suneids/Glove/electronics/Glove_Alrium/Glove_Altium.pdf

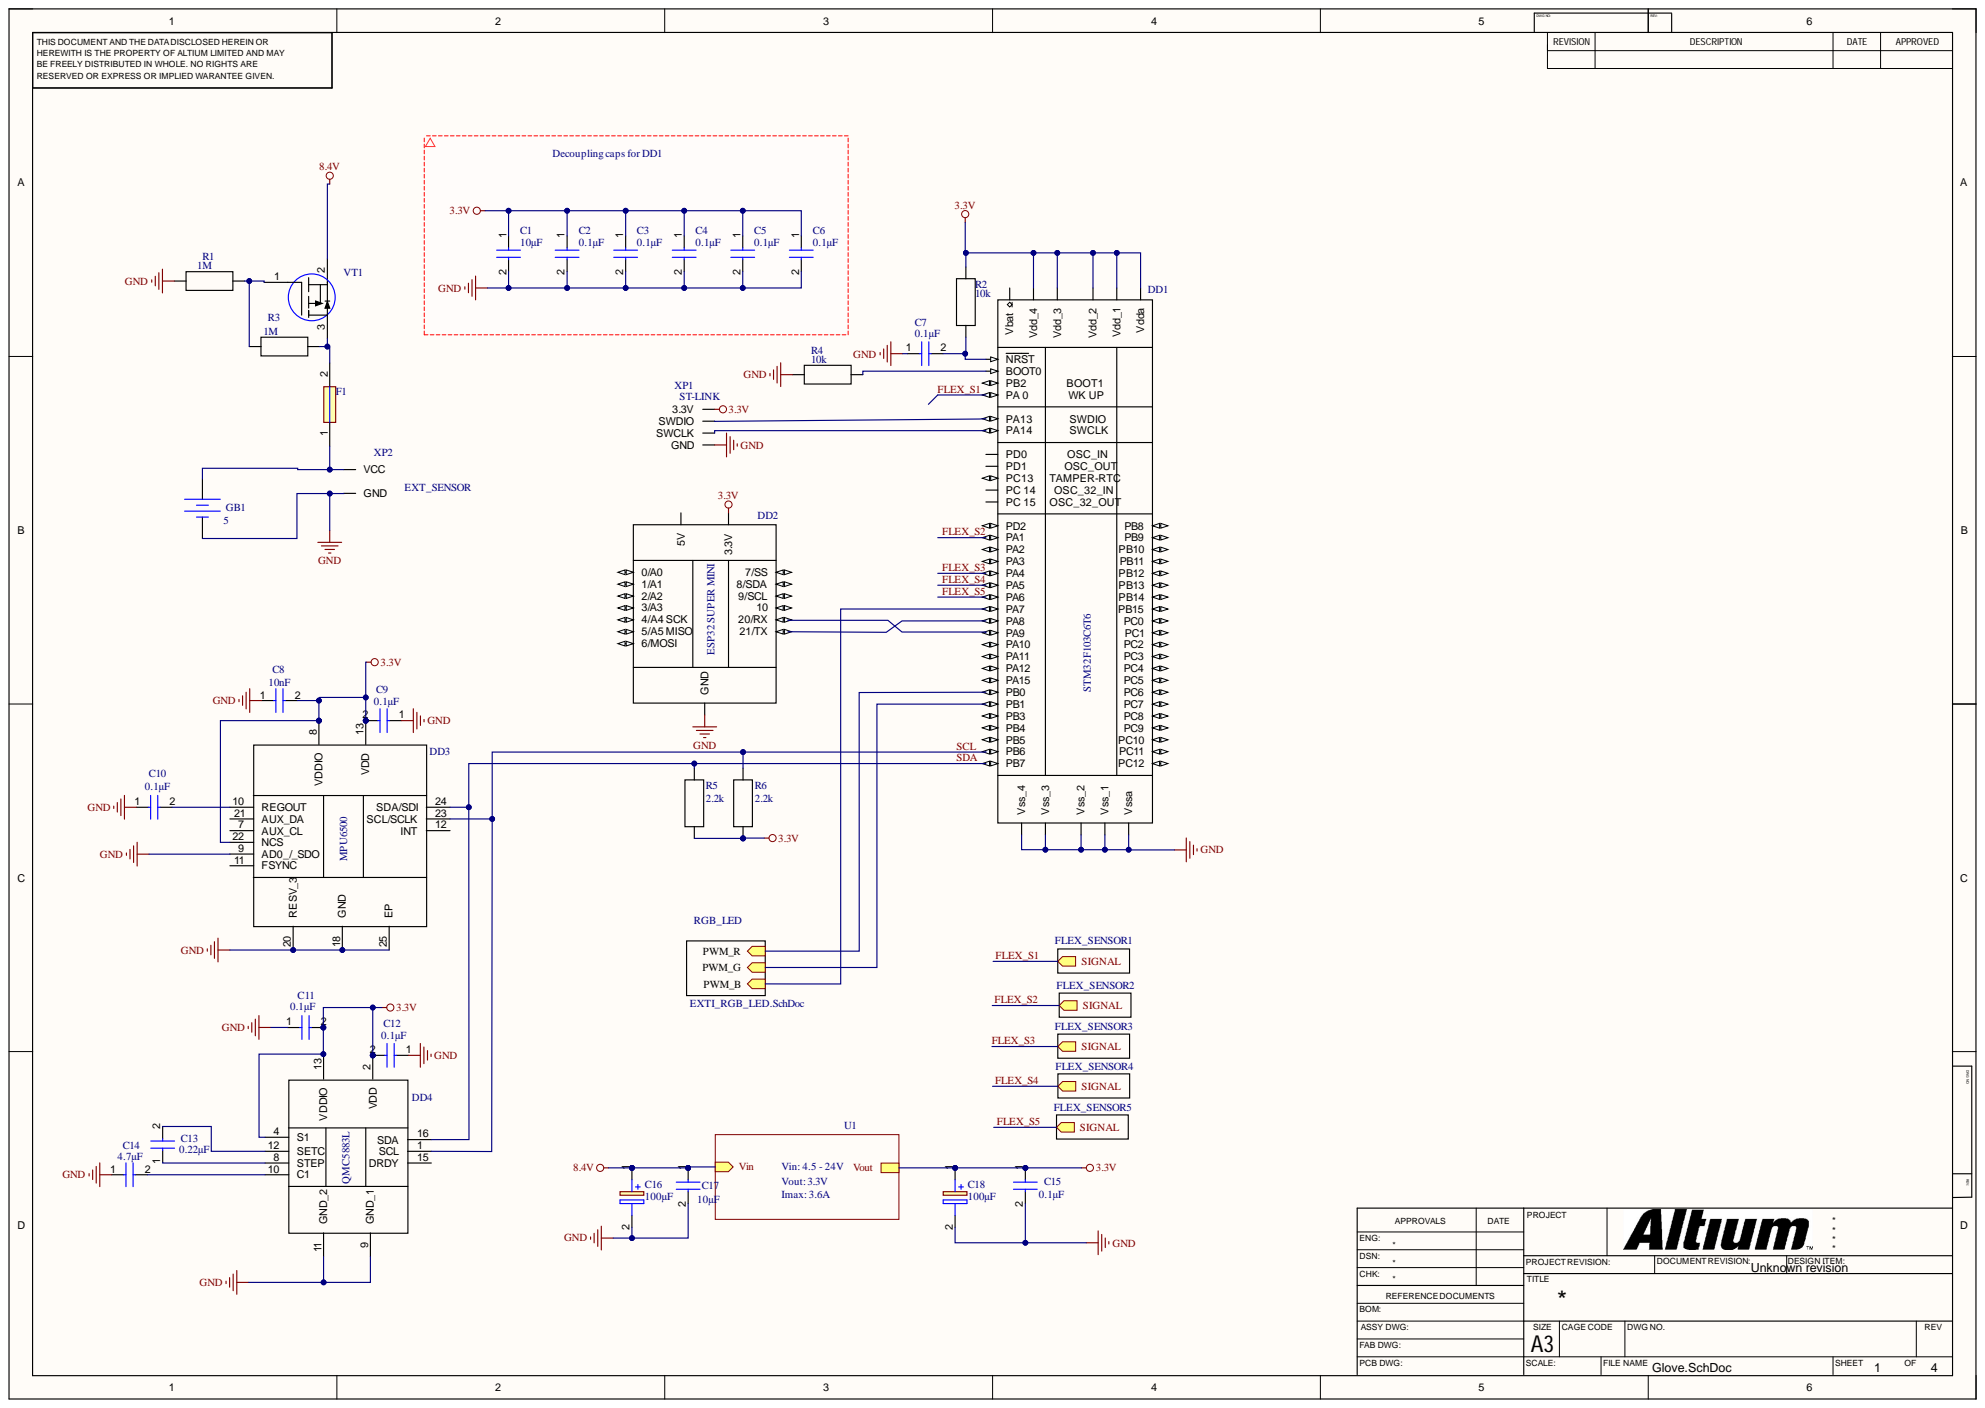
[picture p1: page 1]

DWG NO: | REV:

THIS DOCUMENT AND THE DATADISCLOSED HEREIN OR HEREWITH IS THE PROPERTY OF ALTIUM LIMITED AND MAY BE FREELY DISTRIBUTED IN WHOLE. NO RIGHTS ARE RESERVED OR EXPRESS OR IMPLIED WARANTEE GIVEN. | | REVISION | DESCRIPTION | DATE | APPROVED

NRST BOOT0 PB2 PA 0 | BOOT1 WK UP

PA13 PA14 | SWDIO SWCLK

PD0 PD1 PC13 PC 14 | OSC_IN OSC_OUT TAMPER-RTC OSC_32_IN

DATE | PROJECT | * * APPROVALS * *

ENG: *

DSN: * | | PROJECTREVISION: | DOCUMENTREVISION: Unknown revision | DESIGN ITEM:

CHK: *

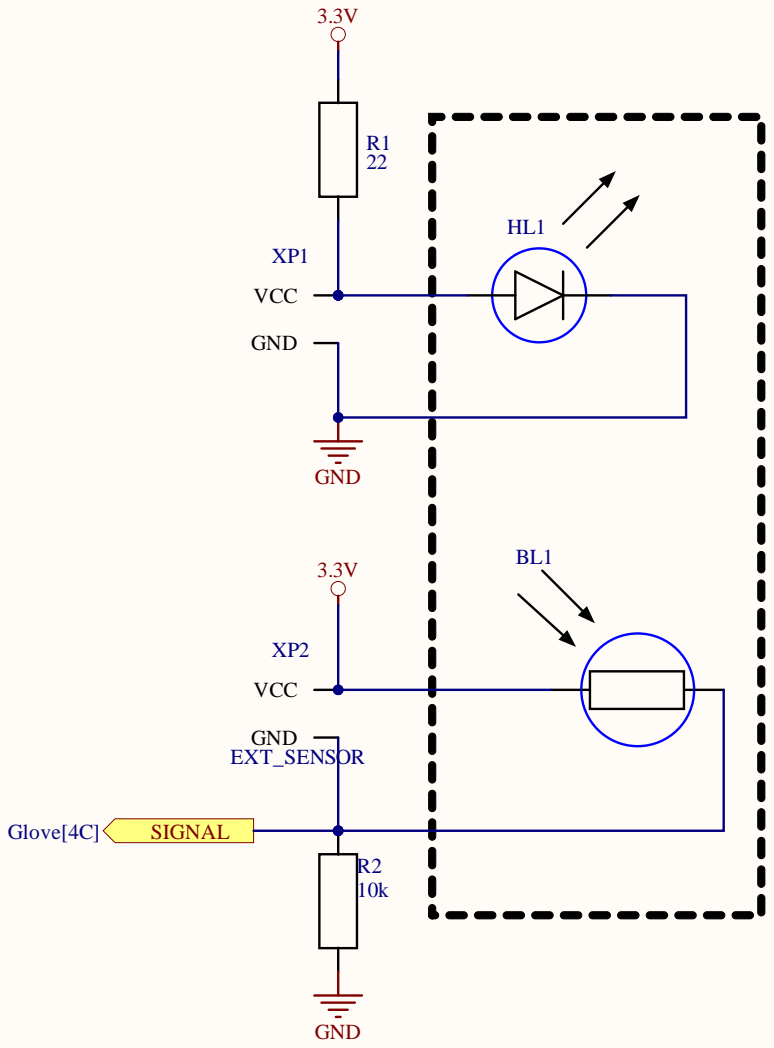
[picture p2: page 2]

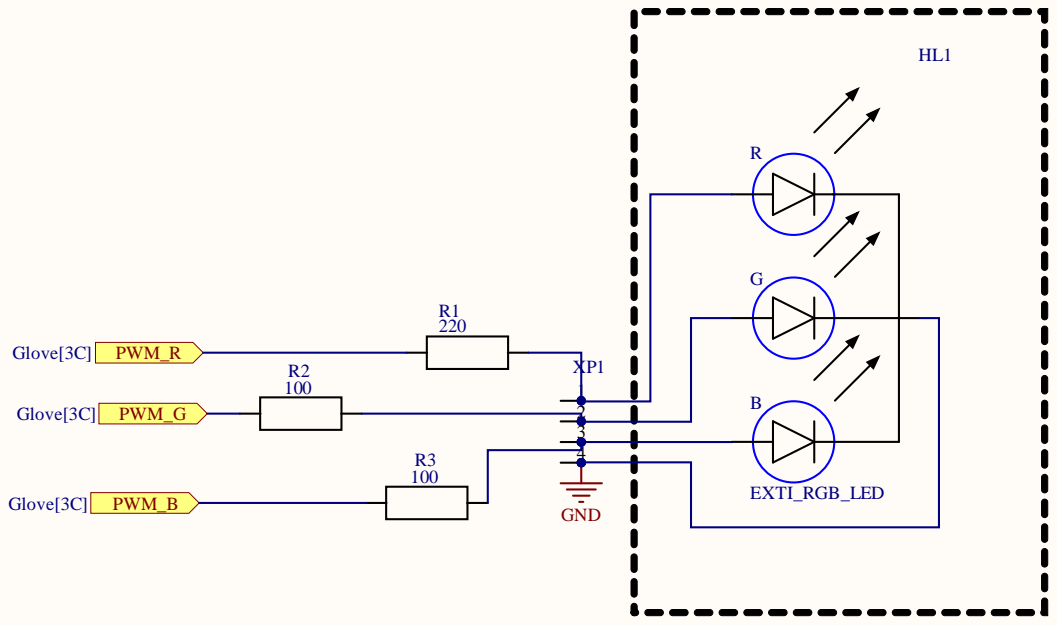
[picture p3: page 3]

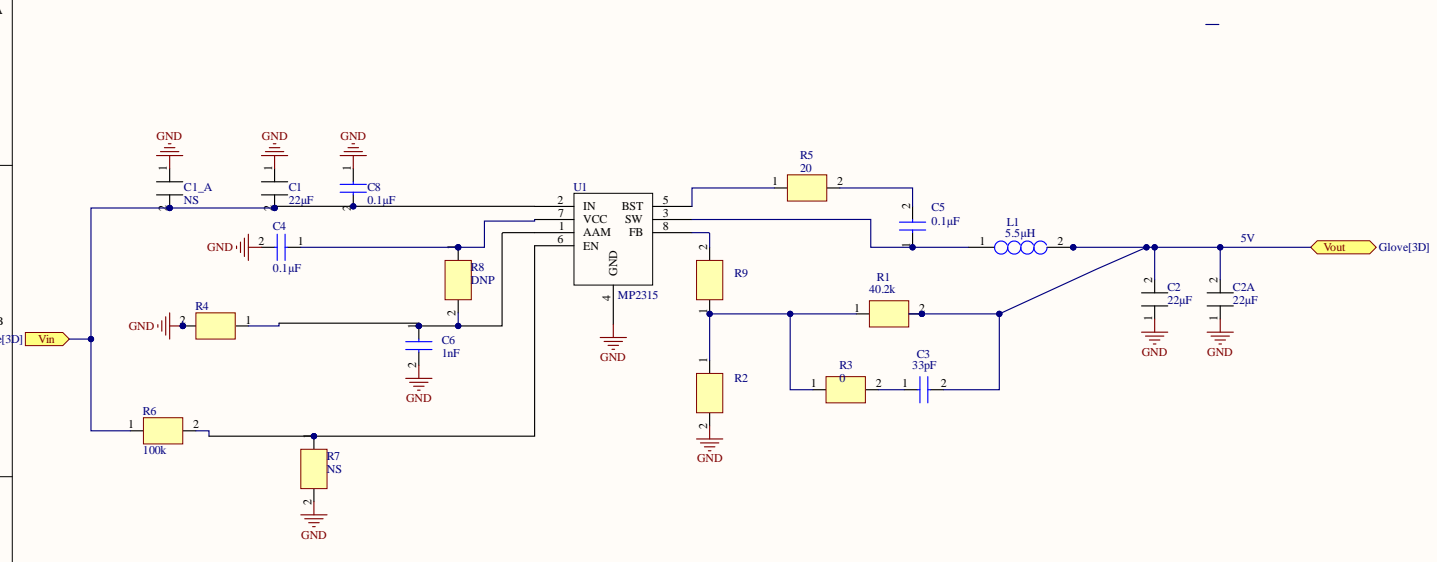
[picture p4: page 4]
