suneids/Glove/(list of files, drawings)

Other design files:
electronics/Glove_Alrium/EXT_FLEX_SENSOR.SchDoc
electronics/Glove_Alrium/EXTI_RGB_LED.SchDoc
electronics/Glove_Alrium/Glove_Altium.PrjPcb
