suneids/Glove/electronics/kicad_scheme/EXTI_RGB_LED.kicad_sch

## KiCad design electronics/kicad_scheme/EXTI_RGB_LED.kicad_sch (2026-10-30)

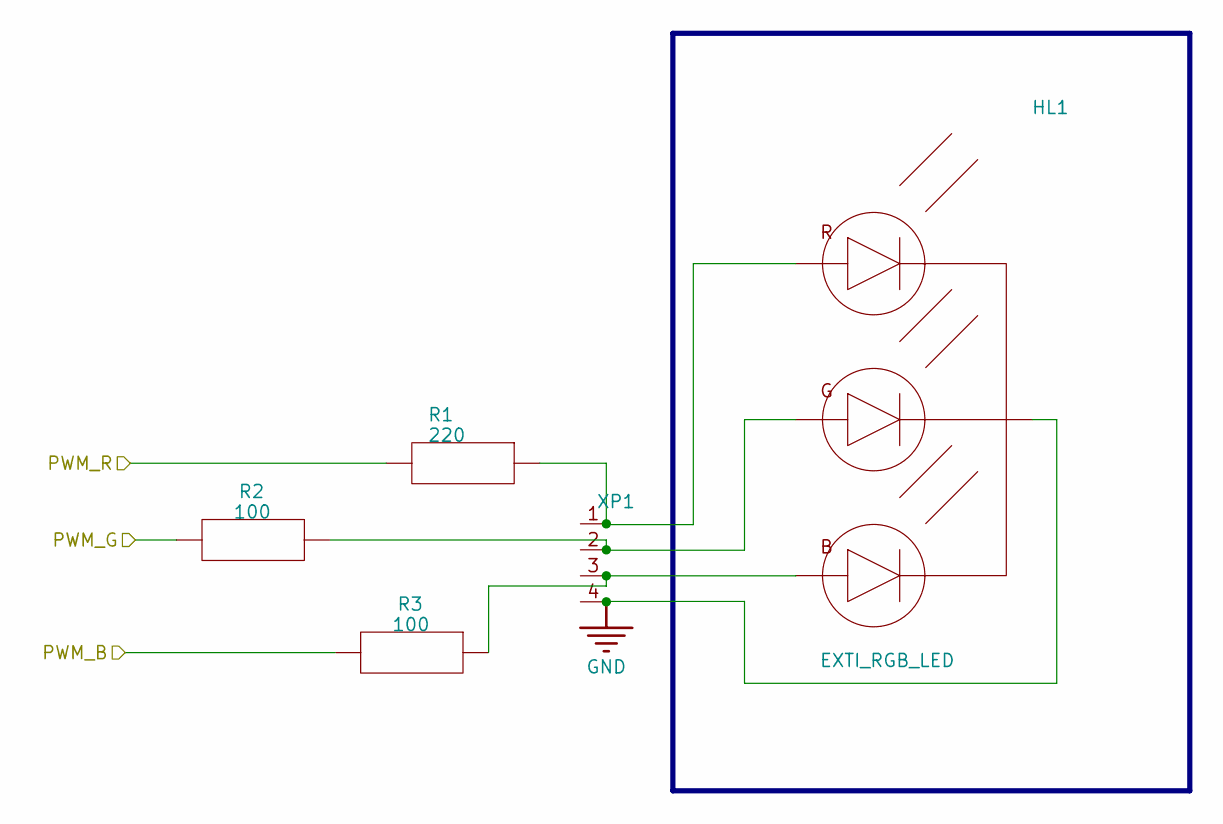
[picture p5: schematic EXTI_RGB_LED.kicad_sch]

Parts:
HL1: EXTI_RGB_LED
R1: 220; CAPC2012X145N; MANUFACTURER_PART_NUMBER CL21A106KAYNNNE; MOUSER PART NUMBER 187-CL21A106KAYNNNE
R2, R3: 100; CAPC2012X145N; MANUFACTURER_PART_NUMBER CL21A106KAYNNNE; MOUSER PART NUMBER 187-CL21A106KAYNNNE
XP1: EXT_SENSOR_4pin

Connections:
unnamed: HL1.0, R1.1, XP1.1 (VCC)
unnamed: HL1.1, R2.1, XP1.2 (IN)
unnamed: HL1.2, R3.1, XP1.3 (IN)
unnamed: HL1.4, XP1.4 (IN)
PWM_B: R3.2
PWM_G: R2.2
PWM_R: R1.2
