suneids/Glove/electronics/kicad_scheme/EXT_FLEX_SENSOR.kicad_sch

## KiCad design electronics/kicad_scheme/EXT_FLEX_SENSOR.kicad_sch (2026-10-30)

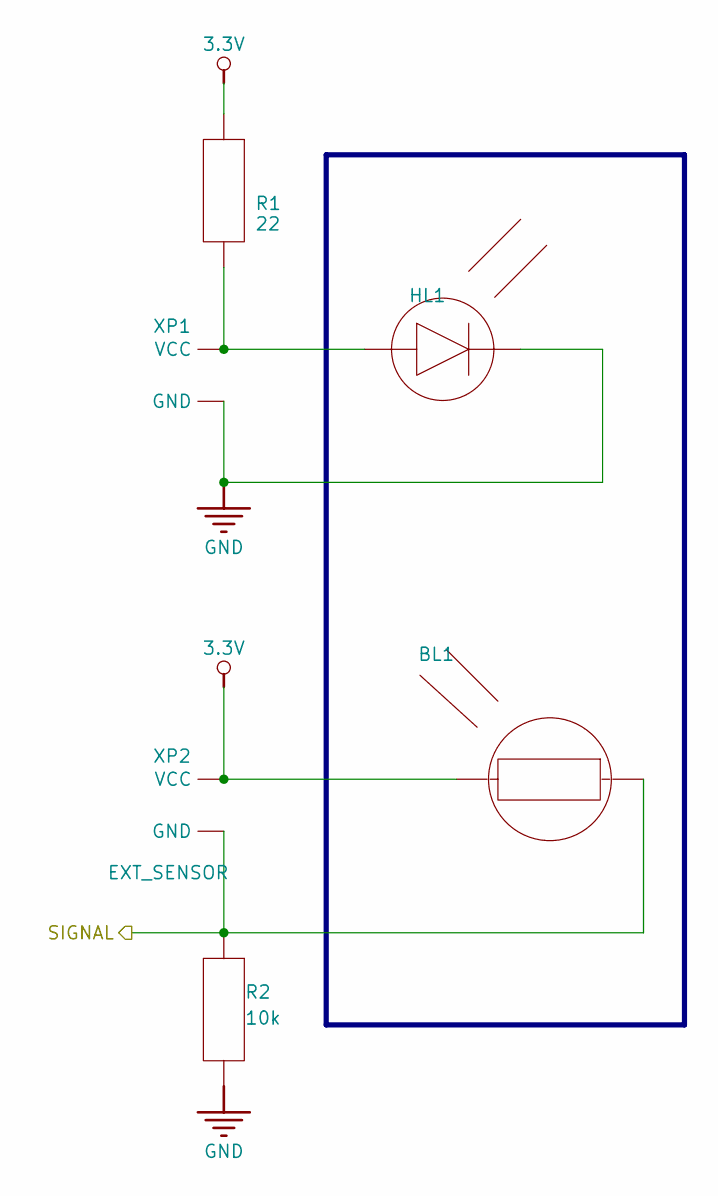
[picture p6: schematic EXT_FLEX_SENSOR.kicad_sch]

Parts:
BL1: (no value)
HL1: (no value)
R1: 22; CAPC2012X145N; MANUFACTURER_PART_NUMBER CL21A106KAYNNNE; MOUSER PART NUMBER 187-CL21A106KAYNNNE
R2: 10k; CAPC2012X145N; MANUFACTURER_PART_NUMBER CL21A106KAYNNNE; MOUSER PART NUMBER 187-CL21A106KAYNNNE
XP1: EXT_SENSOR
XP2: EXT_SENSOR

Connections:
unnamed: BL1.0, XP2.1 (VCC)
unnamed: HL1.0, R1.1, XP1.1 (VCC)
unnamed: HL1.1, XP1.2 (GND)
SIGNAL: BL1.1, R2.2, XP2.2 (GND)
