suneids/Glove/electronics/kicad_scheme/Glove.kicad_sch

## KiCad design electronics/kicad_scheme/Glove.kicad_sch (2026-10-30)

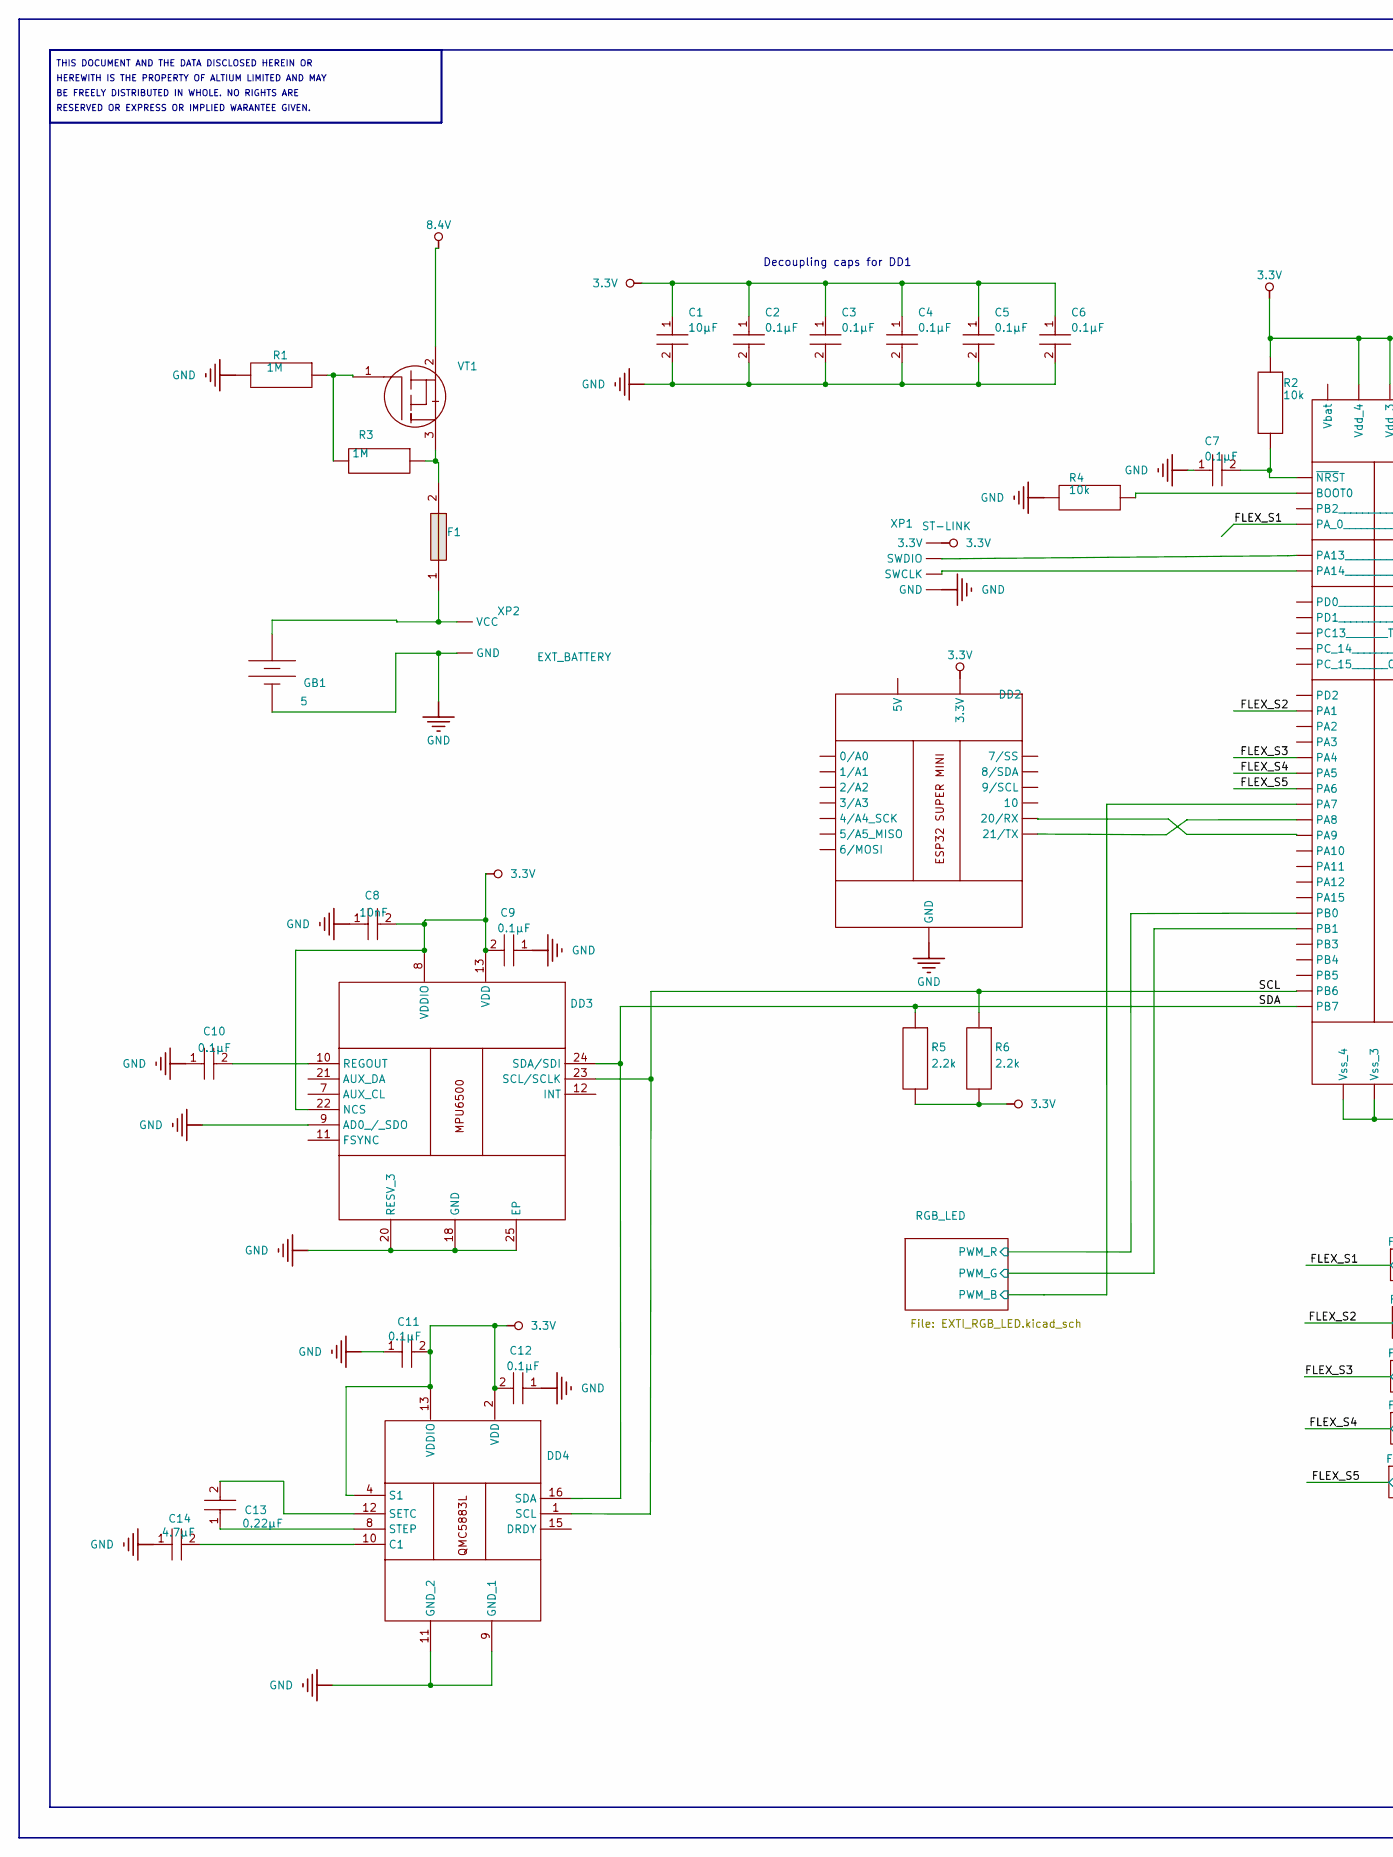
[picture p7: schematic Glove.kicad_sch, part in row 1, column 1]

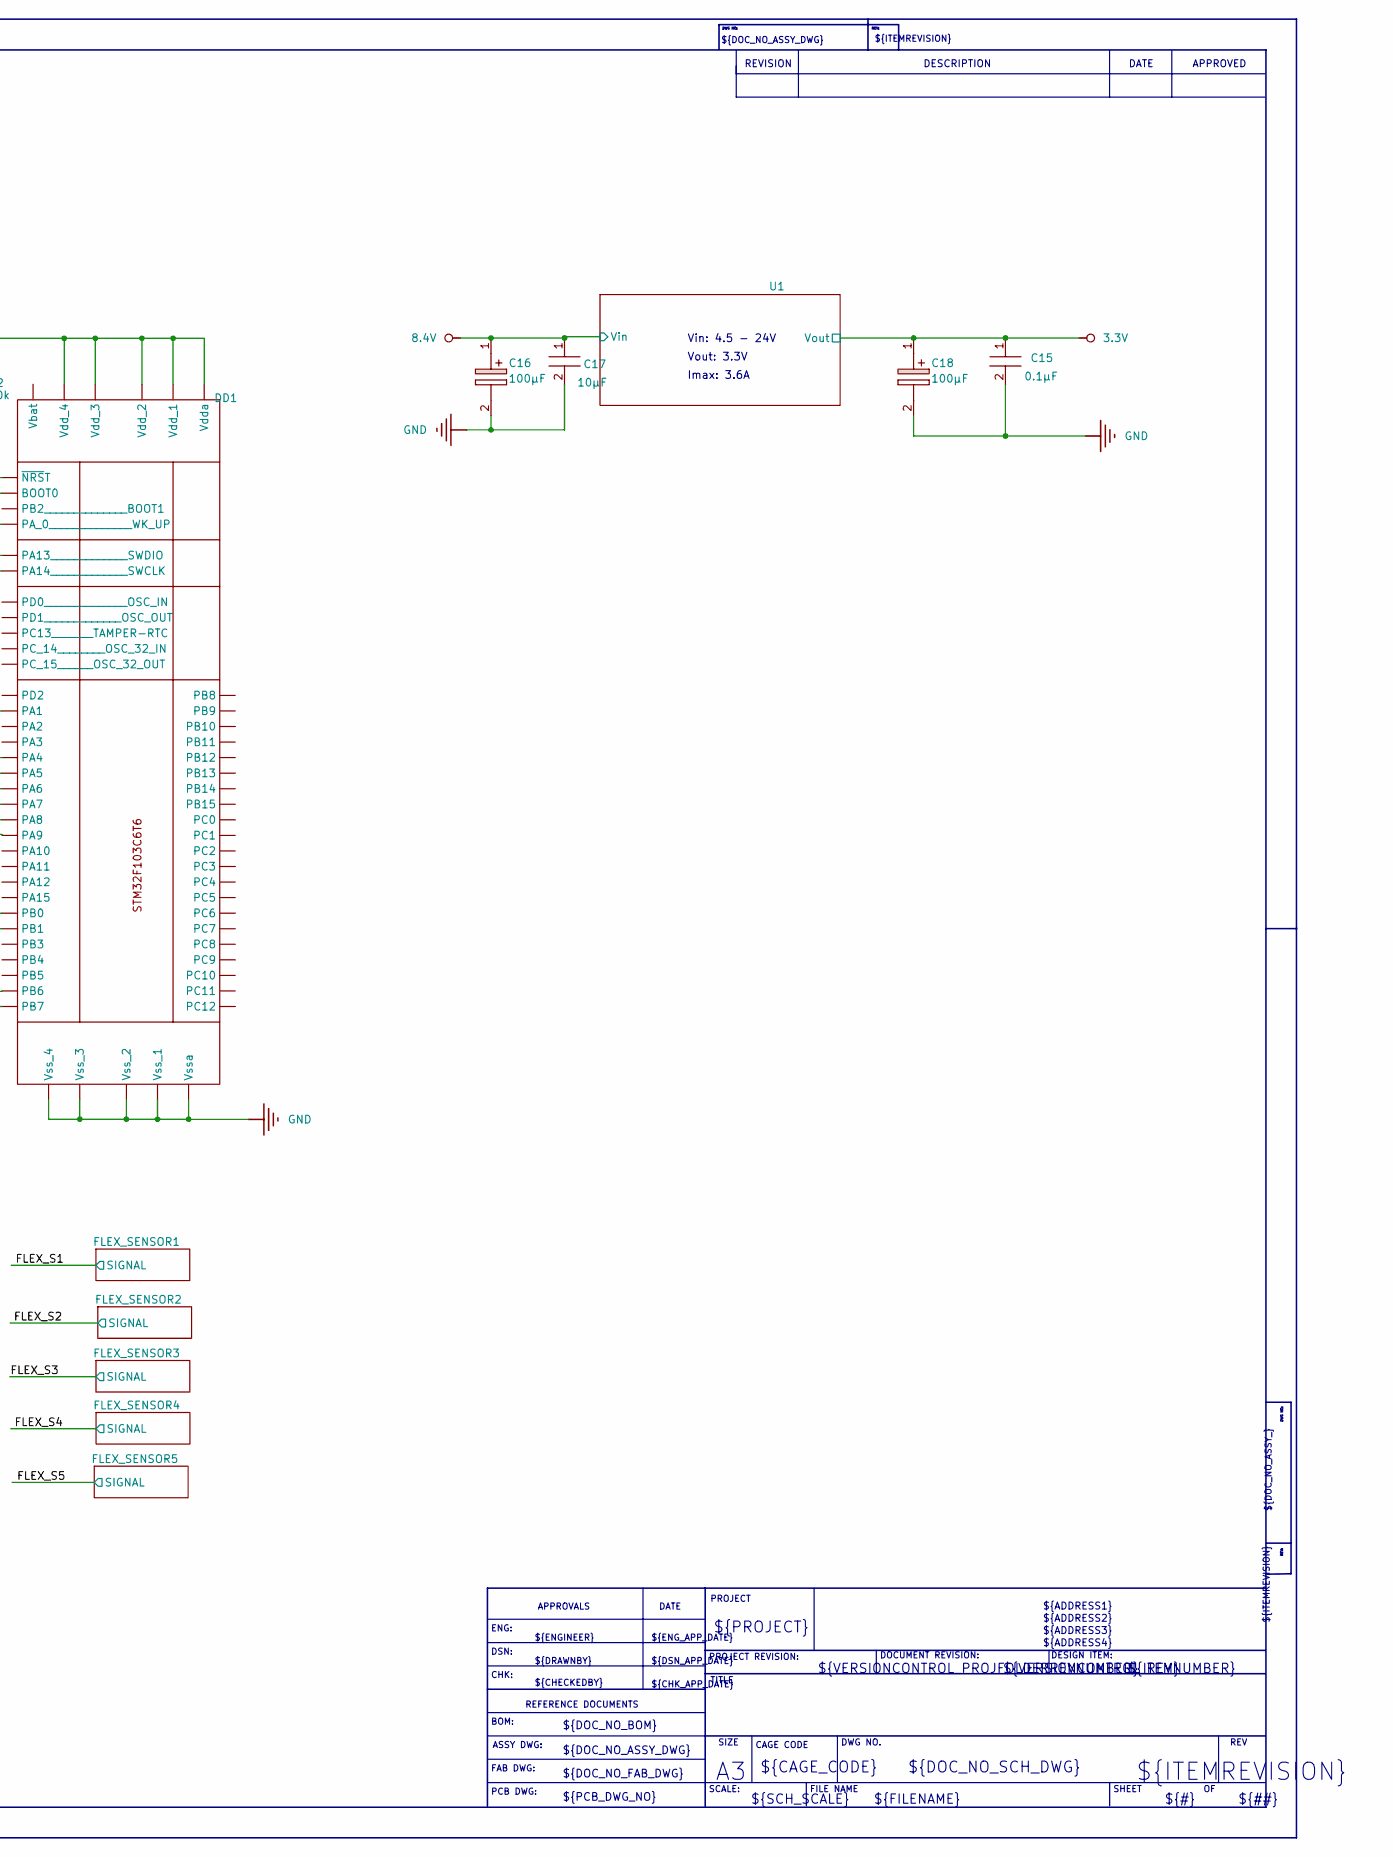
[picture p8: schematic Glove.kicad_sch, part in row 1, column 2]

Parts:
C1, C17: 10µF; CAPC2012X145N; MANUFACTURER_PART_NUMBER CL21A106KAYNNNE; MOUSER PART NUMBER 187-CL21A106KAYNNNE
C2, C3, C4, C5, C6, C7, C9, C10, C11, C12, C15: 0.1µF; CAPC2012X145N; MANUFACTURER_PART_NUMBER CL21A106KAYNNNE; MOUSER PART NUMBER 187-CL21A106KAYNNNE
C8: 10nF; CAPC2012X145N; MANUFACTURER_PART_NUMBER CL21A106KAYNNNE; MOUSER PART NUMBER 187-CL21A106KAYNNNE
C13: 0.22µF; CAPC2012X145N; MANUFACTURER_PART_NUMBER CL21A106KAYNNNE; MOUSER PART NUMBER 187-CL21A106KAYNNNE
C14: 4.7µF; CAPC2012X145N; MANUFACTURER_PART_NUMBER CL21A106KAYNNNE; MOUSER PART NUMBER 187-CL21A106KAYNNNE
C16, C18: 100µF; T491C; MANUFACTURER_PART_NUMBER T491C107M016AT; MOUSER PART NUMBER 80-T491C107M016AT
DD1: STM32F103C6T6
DD2: ESP32C3_SUPER_MINI
DD3: QFN40P300X300X105-25N-D; MANUFACTURER_PART_NUMBER MPU-6500
DD4: QMC5883L; MANUFACTURER_PART_NUMBER QMC5883L
F1: Schurter USI 8053370874 I = 4A, U = 32V; FUSC3116X70N; MANUFACTURER_PART_NUMBER SF-1206S500-2; MOUSER PART NUMBER 652-SF-1206S500-2
GB1: Constant Voltage Source
R1, R3: 1M; CAPC2012X145N; MANUFACTURER_PART_NUMBER CL21A106KAYNNNE; MOUSER PART NUMBER 187-CL21A106KAYNNNE
R2, R4: 10k; CAPC2012X145N; MANUFACTURER_PART_NUMBER CL21A106KAYNNNE; MOUSER PART NUMBER 187-CL21A106KAYNNNE
R5, R6: 2.2k; CAPC2012X145N; MANUFACTURER_PART_NUMBER CL21A106KAYNNNE; MOUSER PART NUMBER 187-CL21A106KAYNNNE
VT1: IRLML6401; SOT95P237X112-3N; MANUFACTURER_PART_NUMBER IRLML6401
XP1: ST-LINK
XP2: EXT_BATTERY; EXT_SENSOR

Connections:
FLEX_S1: DD1.14 (PA_0______________WK_UP)
FLEX_S2: DD1.15 (PA1)
FLEX_S3: DD1.20 (PA4)
FLEX_S4: DD1.21 (PA5)
FLEX_S5: DD1.22 (PA6)
unnamed: C1.1, C2.1, C3.1, C4.1, C5.1, C6.1
unnamed: C1.2, C2.2, C3.2, C4.2, C5.2, C6.2
unnamed: C7.2, DD1.7 (~NRST), R2.2
unnamed: C8.2, C9.2, DD3.8 (VDDIO), DD3.13 (VDD), DD3.22 (NCS)
unnamed: C10.2, DD3.10 (REGOUT)
unnamed: C11.2, C12.2, DD4.2 (VDD), DD4.4 (S1), DD4.13 (VDDIO)
unnamed: C13.1, DD4.8 (STEP)
unnamed: C13.2, DD4.12 (SETC)
unnamed: C14.2, DD4.10 (C1)
unnamed: C15.2, C18.2 (-)
unnamed: C16.2 (-), C17.2
unnamed: DD1.12 (Vssa), DD1.18 (Vss_4), DD1.31 (Vss_1), DD1.47 (Vss_2), DD1.63 (Vss_3)
unnamed: DD1.13 (Vdda), DD1.19 (Vdd_4), DD1.32 (Vdd_1), DD1.48 (Vdd_2), DD1.64 (Vdd_3), R2.1
unnamed: DD1.41 (PA8), DD2.GPIO21 (21/TX)
unnamed: DD1.42 (PA9), DD2.GPIO20 (20/RX)
unnamed: DD1.46 (PA13_____________SWDIO), XP1.SWDIO
unnamed: DD1.49 (PA14_____________SWCLK), XP1.SWCLK
unnamed: DD1.60 (BOOT0), R4.2
unnamed: DD3.18 (GND), DD3.20 (RESV_3), DD3.25 (EP)
unnamed: DD4.9 (GND_1), DD4.11 (GND_2)
unnamed: F1.1, GB1.1, XP2.1 (VCC)
unnamed: F1.2, R3.2, VT1.3 (D)
unnamed: GB1.2, XP2.2 (GND)
unnamed: R1.2, R3.1, VT1.1 (G)
unnamed: R5.1, R6.1
SCL: DD1.58 (PB6), DD3.23 (SCL/SCLK), DD4.1 (SCL), R6.2
SDA: DD1.59 (PB7), DD3.24 (SDA/SDI), DD4.16 (SDA), R5.2
Vin: C16.1 (+), C17.1
Vout: C15.1, C18.1 (+)

Notes on the sheet:
THIS DOCUMENT AND THE DATA DISCLOSED HEREIN OR
RESERVED OR EXPRESS OR IMPLIED WARANTEE GIVEN.
${#}
Vout: 3.3V
PROJECT
ASSY DWG:
${TITLE}
DWG NO:
FILE NAME
${DOC_NO_BOM}
APPROVED
${DRAWNBY}
CHK:
BOM:
HEREWITH IS THE PROPERTY OF ALTIUM LIMITED AND MAY
${ADDRESS1}
${ITEM}
${VERSIONCONTROL_PROJFOLDERREVNUMBER}
${CHK_APP_DATE}
APPROVALS
SCALE:
${ITEMREVISION}
TITLE
${PCB_DWG_NO}
DSN:
${ADDRESS2}
PROJECT REVISION:
DESIGN ITEM:
DATE
${CHECKEDBY}
Decoupling caps for DD1
BE FREELY DISTRIBUTED IN WHOLE. NO RIGHTS ARE
${ADDRESS3}
ENG:
${FILENAME}
FAB DWG:
DOCUMENT REVISION:
${VERSIONCONTROL_REVNUMBER}
${DOC_NO_ASSY_DWG}
${DOC_NO_FAB_DWG}
CAGE CODE
SIZE
${DSN_APP_DATE}
REVISION
REFERENCE DOCUMENTS
REV:
DESCRIPTION
${ENG_APP_DATE}
Imax: 3.6A
${PROJECT}
DWG NO.
REV
${DOC_NO_ASSY_}
${##}
${CAGE_CODE}
${ENGINEER}
PCB DWG:
SHEET
${DOC_NO_SCH_DWG}
${SCH_SCALE}
${ADDRESS4}
Vin: 4.5 - 24V
